tim4net/opentroll/docs/images/04_spotlock_active.png

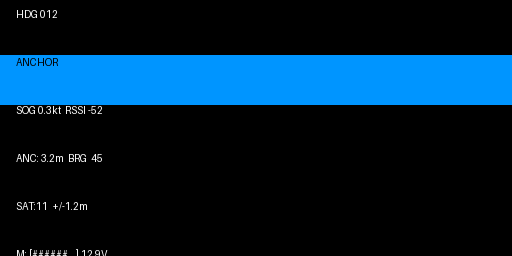
docs/images/04_spotlock_active.png
