tim4net/opentroll/docs/images/08_spotlock_mild.png

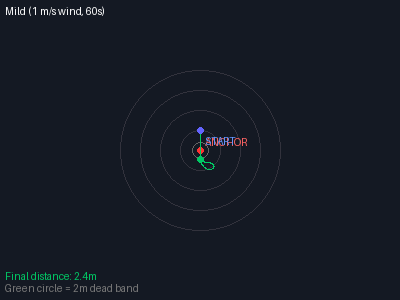
docs/images/08_spotlock_mild.png
