tim4net/opentroll/docs/images/09_system_architecture.png

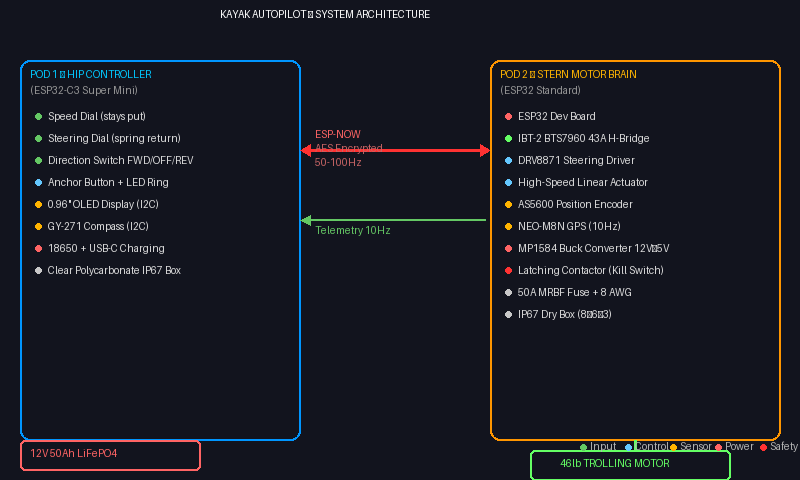
docs/images/09_system_architecture.png
