tim4net/opentroll/docs/images/diagrams/png/architecture.png

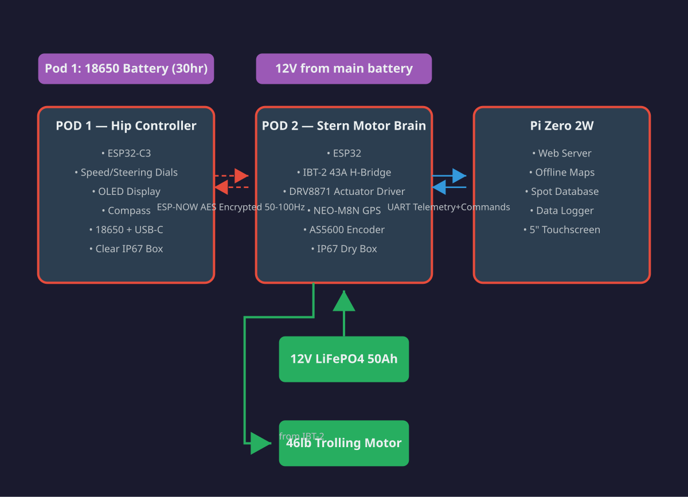
docs/images/diagrams/png/architecture.png
