tim4net/opentroll/docs/images/diagrams/png/power_distribution.png

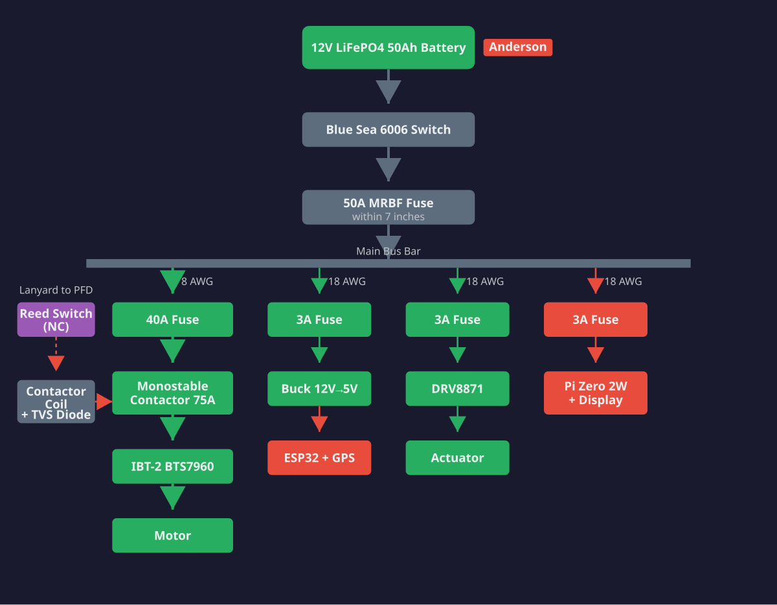
docs/images/diagrams/png/power_distribution.png
