tim4net/opentroll/docs/images/diagrams/png/safety_layers.png

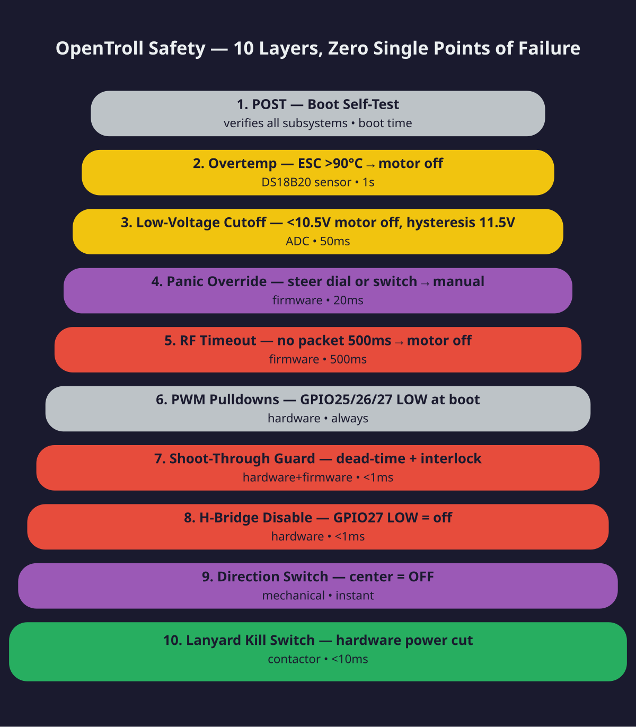
docs/images/diagrams/png/safety_layers.png
