tim4net/opentroll/docs/images/diagrams/png/state_machine.png

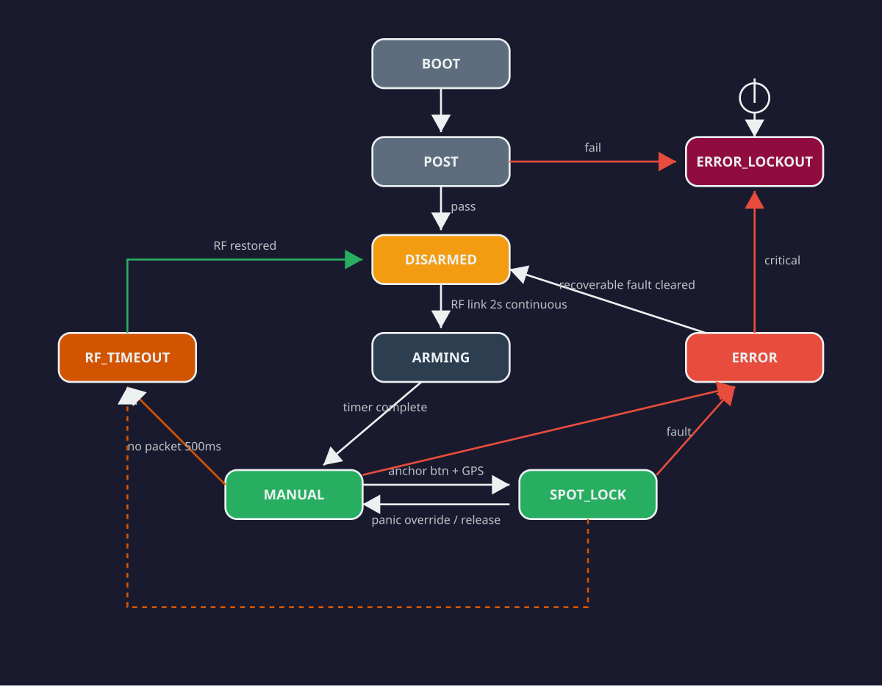
docs/images/diagrams/png/state_machine.png
