tim4net/opentroll/docs/images/02_manual_gps_search.png

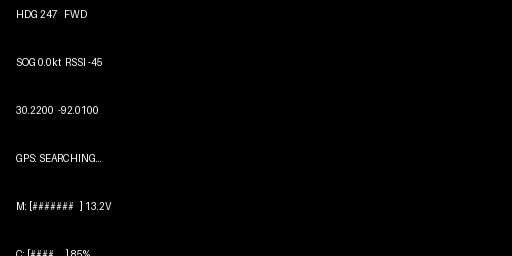
docs/images/02_manual_gps_search.png
