tim4net/opentroll/docs/images/diagrams/png/pod2_wiring.png

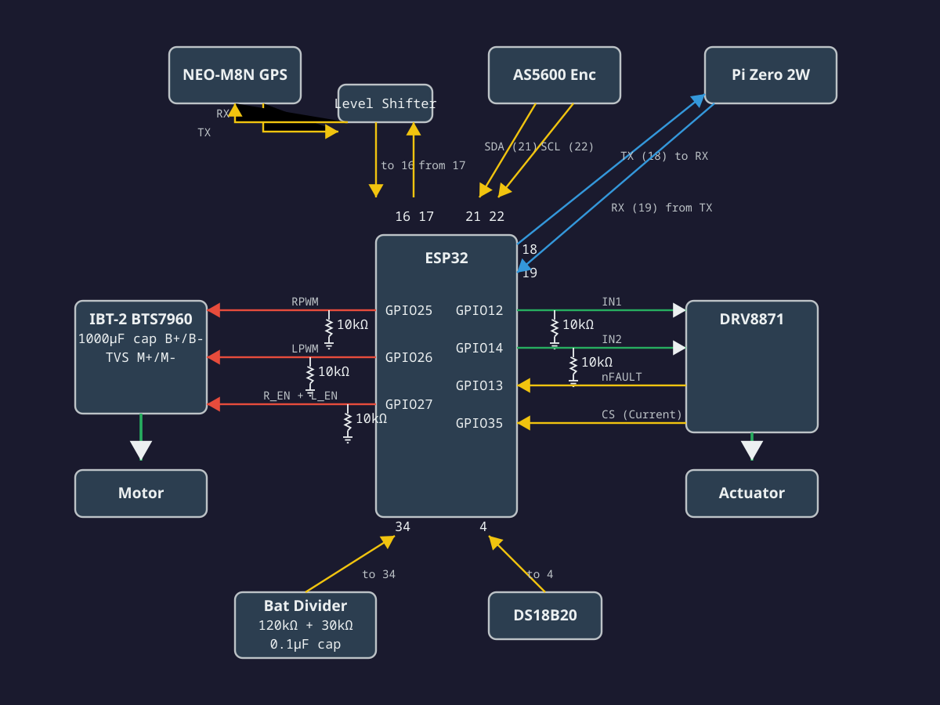
docs/images/diagrams/png/pod2_wiring.png
