tim4net/opentroll/docs/images/07_test_results.png

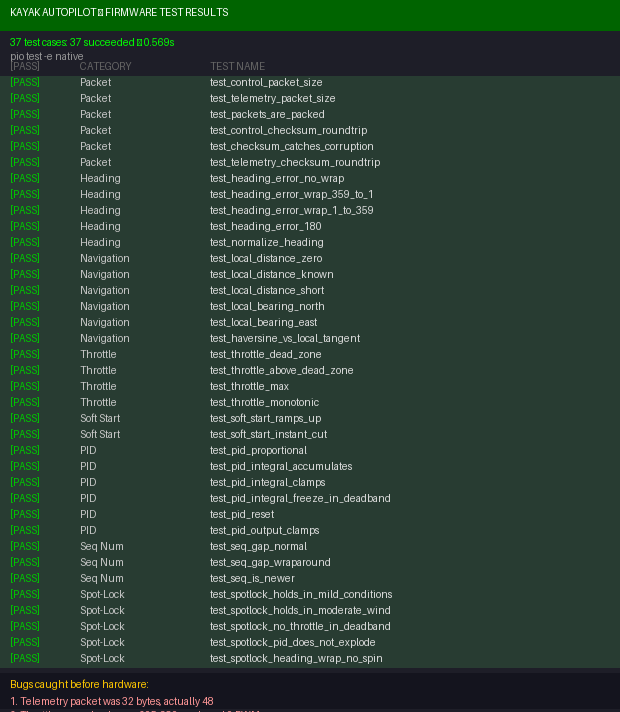
docs/images/07_test_results.png
