tim4net/opentroll/(commit log)

2026-07-12 Initial commit — OpenTroll open-source trolling motor autopilot
2026-07-12 Add firmware source, unit tests (37 passing), docs with screenshots
    - firmware/src/: packed packet structs, navigation math, PID controller, throttle curve
    - firmware/test/: 37 unit tests covering packets, PID, spot-lock simulation, heading math
    - firmware/platformio.ini: native test + ESP32 + ESP32-C3 targets
    - docs/images/: OLED mockups, test results, spot-lock simulation plots, architecture diagram
2026-07-12 Add Pod 1 controller + Pod 2 motor brain firmware, firmware README
    - pod1_controller/main.cpp: ESP32-C3 controller (OLED, pots, buttons, ESP-NOW TX)
    - pod2_motor/main.cpp: ESP32 motor brain (state machine, spot-lock, safety, PWM)
    - wokwi/: Browser simulator (sketch.ino + diagram.json)
    - firmware/README.md: Build + test + flash instructions
    - Fixed pod2 test references
    [main.cpp, sketch.ino, test_main.cpp]
2026-07-12 Add engineering diagrams, corrected system spec v3
    5 professional SVG diagrams (generated via Gemini, reviewed by EE + CS engineers):
    - architecture.svg: System overview (Pod 1 ↔ Pod 2 ↔ Pi Zero)
    - power_distribution.svg: Battery → disconnect → fuse → 4 branches + kill switch
    - pod2_wiring.svg: ESP32 pin-level wiring (all corrected GPIO assignments)
    - state_machine.svg: Firmware state machine with all transitions
    - safety_layers.svg: 10-layer safety stack
    system-spec-v3.txt: Locked spec after 3 review rounds (14 critical issues found and fixed)
    Pin assignment corrections applied:
    - UART1 moved from GPIO9/10 (flash pins) to GPIO18/19
    - DRV8871 CS moved from GPIO15 (ADC2) to GPIO35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
2026-07-12 Update protection to resettable — Blue Sea thermal breakers + blade reset fuses
    - Battery main: MRBF → Blue Sea 7050 50A thermal breaker
    - Motor branch: ANL → Blue Sea 7030 40A thermal breaker
    - Electronics/Steering/Pi: ATO blade → manual-reset blade fuse kit (3-30A)
    - Pod 1 18650: PTC polyfuse (auto-reset)
    - All protection now resettable — zero spare fuses needed on water
    Shopping list updated (item 18, 19, 19a)
2026-07-13 Fix steering: detented pot (not spring-return) + heading-command mode
    - Steering pot: WH148 center-detent, holds bias angle, no snap-back
    - Firmware: pot commands motor-head angle (heading mode), not turn-rate
    - Set a crosswind/current bias, let go, boat holds the bias course
    - Matches hand-tiller ergonomics; panic override unchanged
    BOM + master table updated (item 24)
2026-07-13 Fix Blue Sea breaker MPNs: 7050/7030 were 3A/30A; correct to 7250/7270 (50A/40A)
    Critical spec correction found during supplier research:
    - Blue Sea 7050 = 3A, 7030 = 30A (NOT 50A/40A)
    - Correct parts: 7250 (50A main), 7270 (40A motor branch)
    - Both verified available genuine at BoatID (~.54) shipped to LA
    BOM + spec updated. Supplier price-check table added to Obsidian BOM Master Table.
2026-07-15 Safety review: electrical, nautical, and RF fixes (9 commits, 51 tests passing) (#1)
    * fix(battery): correct ADC divider math, add filtering + hysteresis + limp mode
    - Firmware still used the old 100k/33k divider (x4.03). Spec v3 corrected
    this to 120k/30k because at 14.6V full LiFePO4 charge the old divider
    puts 3.62V on GPIO34 — above the ESP32 ADC 3.3V range and at the pin's
    absolute maximum rating.
    - 16-sample moving average (spec) — single ADC reads under motor load are
    noisy and caused nuisance-trip risk on the 10.5V cutoff.
    - CS-5 hysteresis: critical latches at 10.5V; recovery requires >11.5V
    sustained 2s and lands in DISARMED (manual re-arm), never straight back
    to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
    [control.h, main.cpp, test_main.cpp]
